IMJONGBEOM/Automotive_Hydrant_Mobility_System/동작 영상/자율주행.gif

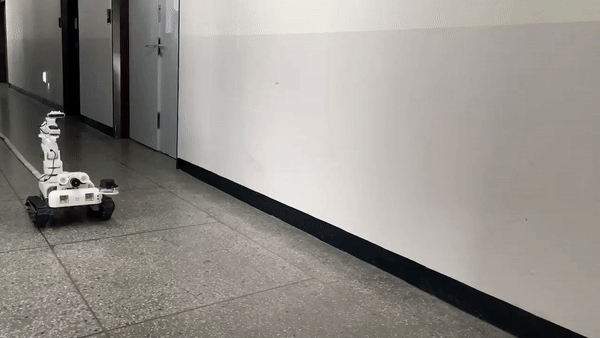
동작 영상/자율주행.gif
