IMJONGBEOM/Automotive_Hydrant_Mobility_System/Encoder/5.ENCODER_Rosserial/pmod_msgs/Readme.md

pmod_msgs 파일은 arduino ide의 라이브러리 중에 OpenCR 보드의 라이브러리에 들어가야 헤더파일을 읽어올수 있다.
