IMJONGBEOM/Automotive_Hydrant_Mobility_System/동작 영상/관창 제어부.gif

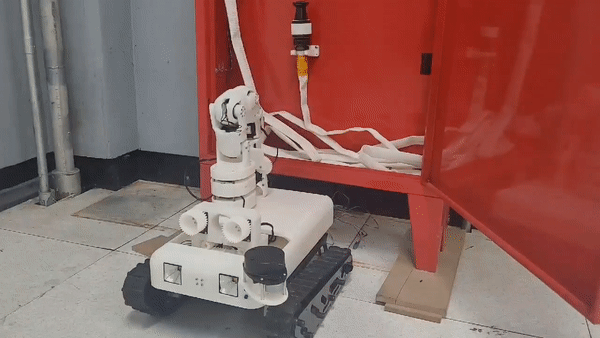
동작 영상/관창 제어부.gif
