IMJONGBEOM/Automotive_Hydrant_Mobility_System/동작 영상/로봇팔.gif

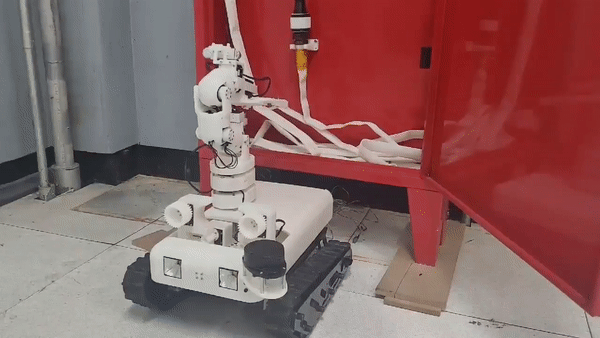
동작 영상/로봇팔.gif
