IMJONGBEOM/Automotive_Hydrant_Mobility_System/동작 영상/맵핑.gif

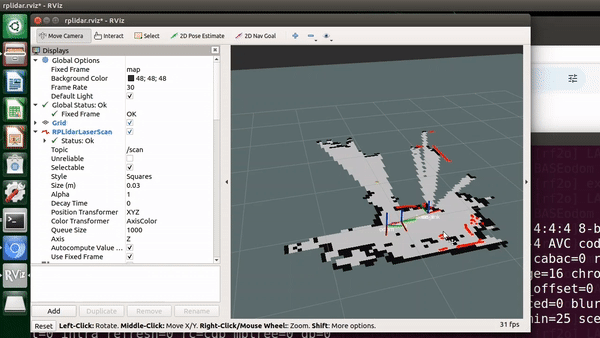
동작 영상/맵핑.gif
