IMJONGBEOM/Automotive_Hydrant_Mobility_System/동작 영상/문 개방 모듈.gif

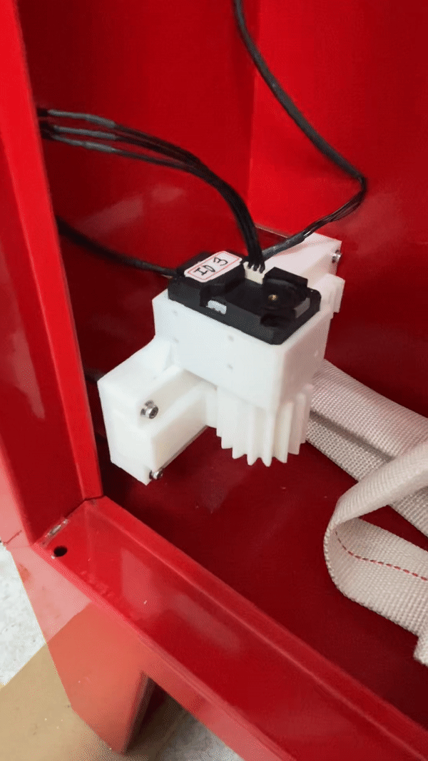
동작 영상/문 개방 모듈.gif
