IMJONGBEOM/Automotive_Hydrant_Mobility_System/동작 영상/분사각 조절부.gif

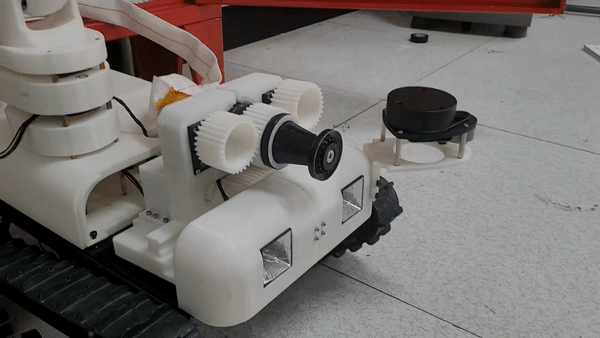
동작 영상/분사각 조절부.gif
