IMJONGBEOM/Automotive_Hydrant_Mobility_System/동작 영상/사람 인식.gif

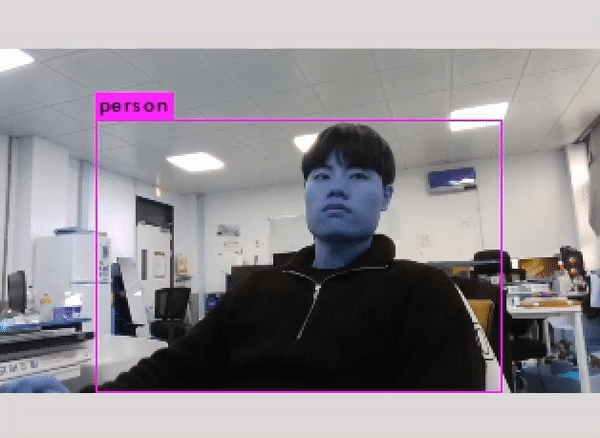
동작 영상/사람 인식.gif
