IMJONGBEOM/Automotive_Hydrant_Mobility_System/Encoder/5.ENCODER_Rosserial/5.ENCODER_Rosserial.ino

/*
 * rosserial Publisher Example
 * Prints "hello world!"
 */

// Use the following line if you have a Leonardo or MKR1000
//#define USE_USBCON

#include <ros.h>
#include<pmod_msgs/Position.h>  // Define a custom message for position

ros::NodeHandle nh;

std_msgs::String str_msg;
ros::Publisher chatter("chatter", &str_msg);

char hello[13] = "hello world!";

void setup()
{
  nh.initNode();
  nh.advertise(chatter);
}

void loop()
{
  str_msg.data = hello;
  chatter.publish( &str_msg );
  nh.spinOnce();
  delay(1000);
}
