IMJONGBEOM/Automotive_Hydrant_Mobility_System/(commit log)

2025-11-23 Create ArduinoUno_BL_AT_MODE
2025-11-23 Fix image tag in 수행 일정 section
    Updated image tag in the schedule section of README.
